seventer/multisensor/hardware/sensDuino1_bb.png

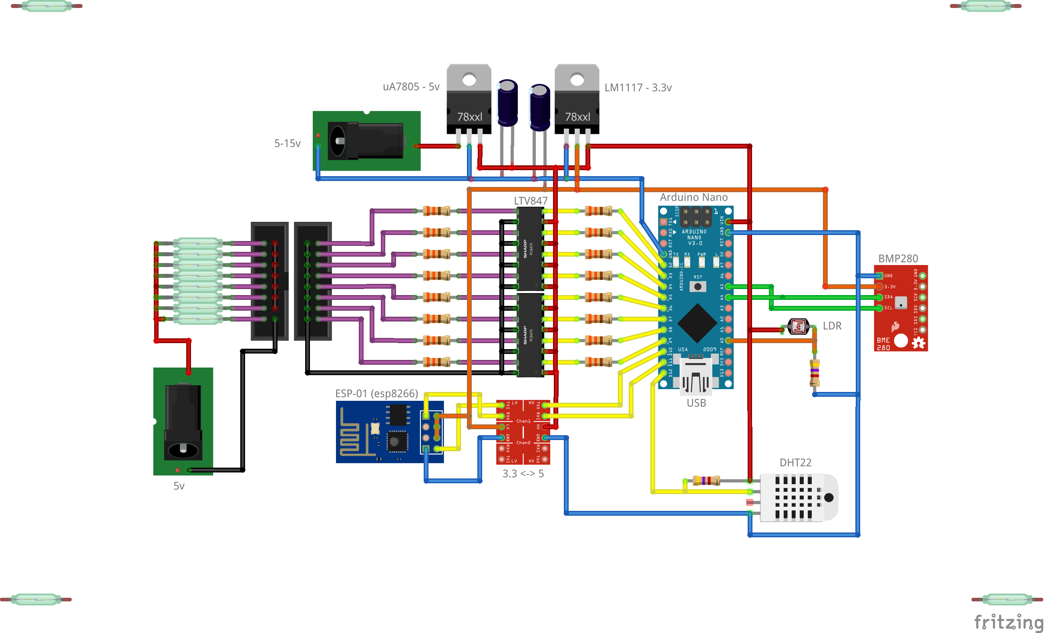
hardware/sensDuino1_bb.png
