seventer/multisensor/(list of files, drawings)

Other design files:
hardware/rpm-01.fzz
hardware/sensDuino1.fzz
hardware/sensDuino2.fzz
