seventer/multisensor/hardware/sensduino1.kicad_pcb

## KiCad design kicad/potenciostato.sch

Schematic: potenciostato.sch

Parts:
J1: Conn_01x03_Female; FanPinHeader_1x03_P2.54mm_Vertical
J3: Conn_01x03_Male; FanPinHeader_1x03_P2.54mm_Vertical
R1: 15K; R_Axial_DIN0207_L6.3mm_D2.5mm_P7.62mm_Horizontal
R2, R3: 100K; R_Axial_DIN0207_L6.3mm_D2.5mm_P7.62mm_Horizontal
R4: 1K; R_Axial_DIN0207_L6.3mm_D2.5mm_P7.62mm_Horizontal
R5: 1M; R_Axial_DIN0207_L6.3mm_D2.5mm_P7.62mm_Horizontal
U1, U3, U4: OP77; DIP-8_W7.62mm_LongPads
U2: TL082; DIP-8_W7.62mm_LongPads

Notes on the sheet:
Amplificador Transresistencia (AMP TR)
Amplificador Tension Inversor (AMP I1)
Amplificador Tension Inversor (AMP T3)
